Hazard-Harbingers-EC463/LiDAR_Detector_Drone_HH/README_Hardware.md

# Hardware

## Installations    

1. Install and Configure the Arduino IDE as Follows:   
    a. Board Managers:
	i. Arduino SAMD Board Manager
       ii. Sparkfun SAMD Board Manager (dependent on Arduino SAMD Board Manager)
    b. Libraries:
        i. Arduino Low Power (1.2.2)
       ii. Adafruit BusIO (1.15.0)
      iii. Arduino SD 
       iv. Adafruit SleepyDog (1.6.5)
        v. Adafruit Unified Sensor (1.1.14)
       vi. BME68x (1.0.10)
      vii. RadioHead (1.122.1)

2. If flashing a new device/reflashing a current device:
	a. Download Sensor Node and Collector Node Scripts
        b. Connect to SAMD21 via micro USB cable 
        c. Upload Collector Node Script to 1 board (current implementation only supports one collector)
        d. Upload Sensor Node Script to as many boards as needed

3. Testing Proper Functionality/Debugging:

Both Scripts include a DEBUG flag in the header that enables verbose output to the serial console. To debug the design, set this flag to 1 and power on 1 of each board (sensor and collector). The serial monitor should output messages for SD initialization, LoRa initialization and transmission, and BME688 calibration. 

Correct output should look like:

SD card Initialized...
Transmitter Up!
Initialization Done
[output from transmission]


Incorrect output should have one of the following messages:
Radio Init Failing - Freezing
SD Initialization Failed
[no transmission output]	


## Collecting Sensor Data
1. Before collection, insert SD card into to SD card slot in all sensor nodes and the collector  
2. Place the sensor nodes in the critical region, spaced farther than 0.5km
3. Power on sensor nodes by connecting battery terminals to clamp
4. Attach collector node to mount point on the drone
5. Fly drone within 0.5km of each sensor node to trigger LoRa response and collect stored data from sensor nodes
6. After drone returns, data will be stored in the onboard SD card in CSV format
7. Remove SD card from Collector Node and apply post processing as necessary

## Hardware Overview
1. Hardware Specifications and Operation Flow:
The embedded nodes are an expandable and modifiable system used to collect long-term (> 1 Month) data in regions greater than 0.5km. The nodes are designed around a SAMD21 Pro RF microcontroller with an integrated long-range RFM95W LoRa transceiver. The SAMD21 chip natively supports a low-power deep sleep state as well as watchdog and GPIO hardware interrupts. Placing the SAMD21 Pro RF into deep sleep reduces nominal power consumption to 3μA which allows for a greatly extended lifetime when compared to its standard operating mode. Power consumption can be modeled by Power Consumption = 3.3VTactive  23mA + Tsleep 3μATactive+ Tsleep. Tactive and Tsleep are adjusted by modifying the duration of data collection after wake or the wakeup policy. Extending the duration of data collection provides more samples for each collection cycle which may reduce the impact of outliers at the cost of power consumption. A high frequency wakeup policy increases the granularity of data but incurs more wakeup overhead. It is recommended for %Tactive to not exceed 99% of the total deployed time. This restriction ensures maximum battery lifetime.
The RFM95W 915MHz LoRa transceiver has an estimated expected range of 0.5km in forest environments with a dipole wire antenna operating at 10dBm. This figure is adjustable by increasing transmission power or substituting a higher gain antenna in exchange for more power consumption. Higher transmission range increases the minimum distance from the sensor node the drone must reach, but decreases the density of sensor nodes. 
The BME688 sensor and SD card storage peripherals are connected to the SAMD21 Pro RF via the SPI bus. The SAMD21 watchdog timer wakes the board at an interval specified by the wakeup policy and collects ambient temperature, pressure, humidity, node altitude, volatile organic compounds, and sulfur organic compounds. Raw data from each read is stored in CSV format on the sensor node SD card before returning the node to deep sleep. Our wireless transmission and collection protocol is agnostic to the size of each entry in the CSV file, so additional sensors and measurement devices can be added to the node by connecting to the SPI bus and adding the collected values to the CSV write format. 
The drone collector node has the same SAMD21-SD storage framework as the sensor nodes without the sensor peripherals. When active, every 10 seconds it broadcasts a LoRa packet containing a request message. When the sensor node receives the request message it responds by reading the SD card packet by packet and transmitting it to the collector node. Upon sending a packet with the EOF character, the sensor node sets a flag preventing it from sending data for 2 hours to prevent multiple data collection. 
Sensor and collector nodes are powered by two AA batteries connected to the battery terminals on the SAMD21. 
	The enclosure is printed from PLA and has a perforated lid and base to allow sufficient airflow for cooling and air quality and humidity measurement. Future iterations will increase the mounting ergonomics of the enclosure and environmental shielding for the board.

Wiring for Sensor and Collector nodes.  



## Potential Issues
1. Due to the implementation of the LoRa RadioHead library, if the collector node sees multiple sensor node responses simultaneously, the interrupt handler is triggered multiple times before resolution which causes the collector to freeze (panic). If this occurs, return the collector node and restart the node by quickly pressing and releasing the reset button on the front of the SAMD21.

2. The sensor nodes are battery powered. Should a significant number of nodes not return data it is likely they have exceeded their battery life and need to be collected manually. All data collected prior to loss of power will still be stored on the SD card, so no data is lost
