Hazard-Harbingers-EC463/LiDAR_Detector_Drone_HH/Models/figures/cover.png

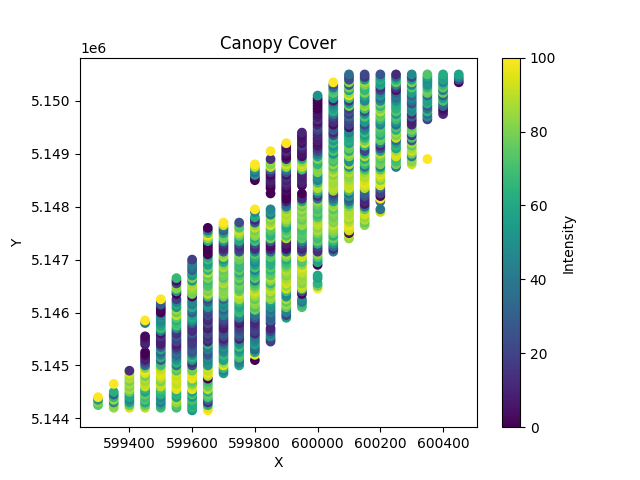
Models/figures/cover.png
