Hazard-Harbingers-EC463/LiDAR_Detector_Drone_HH/Models/figures/density_0_3.png

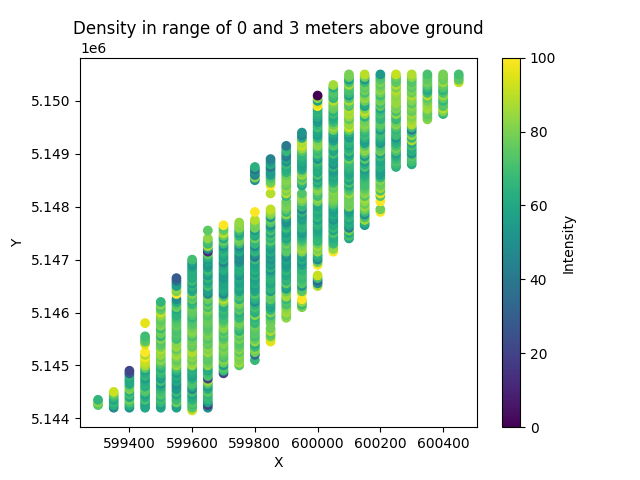
Models/figures/density_0_3.png
