Hazard-Harbingers-EC463/LiDAR_Detector_Drone_HH/Models/figures/density_3_6.png

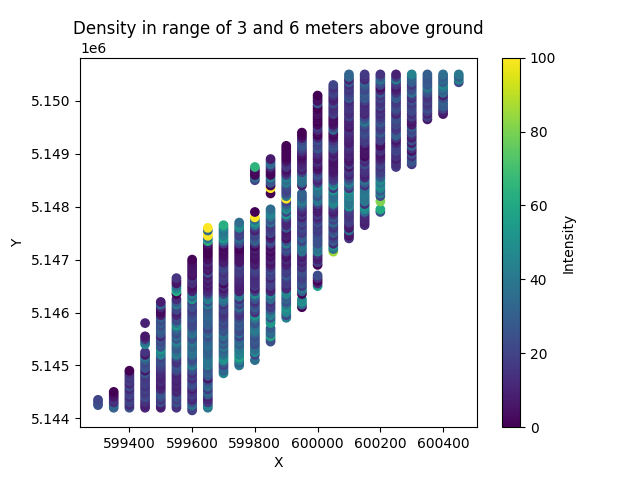
Models/figures/density_3_6.png
