Hazard-Harbingers-EC463/LiDAR_Detector_Drone_HH/Hardware/SnapLidEnclosure.SLDPRT

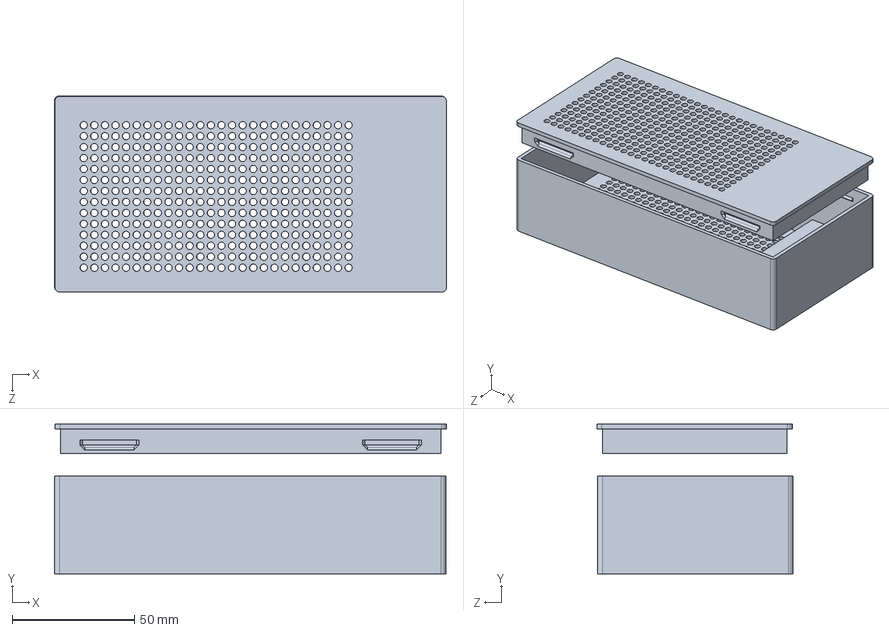
[picture p8: CAD file, 2024-05-03]
Hardware/SnapLidEnclosure.SLDPRT
160.2 x 61.1 x 80.2 mm
