Hazard-Harbingers-EC463/LiDAR_Detector_Drone_HH/Hardware/Part1.SLDPRT

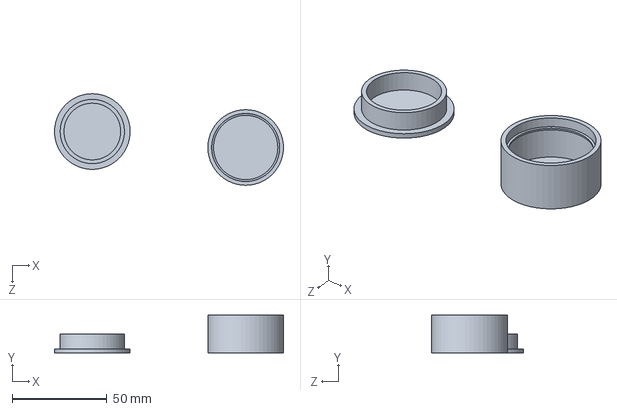
[picture p9: CAD file, 2024-05-03]
Hardware/Part1.SLDPRT
121.1 x 20.0 x 48.4 mm
