Hazard-Harbingers-EC463/LiDAR_Detector_Drone_HH/Hardware/Inspire 1 Pro V2 LiDAR:Jetson Mount - Initial Design.stl

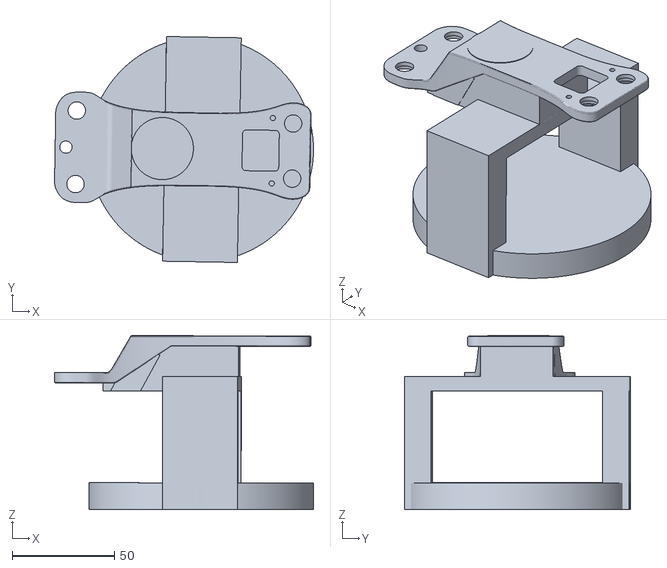
[picture p10: CAD file, 2024-04-28]
Hardware/Inspire 1 Pro V2 LiDAR:Jetson Mount - Initial Design.stl
126.8 x 110.6 x 85.2
