Hazard-Harbingers-EC463/LiDAR_Detector_Drone_HH/(commit log)

2023-10-22 Read LiDAR data and filter ground points
2023-11-16 Fixed parameters for DTM and CHM, fixed ground point classification
2024-04-26 Added the laser assembler launch and run files
2024-04-28 Add files via upload
    Final design revision for the custom drone mount. Credit to Tristan Dolenc for their help with the mechanical design.
2024-05-03 Snapfit Enclosure for Embedded Nodes
    [Part1.SLDPRT, SnapLidEnclosure.SLDPRT]
